BenJWagner/MIYbot/README.md

# MIYbot
MIYbot software and documentation
