BenJWagner/MIYbot/MIYBot Circuit Board BOM - Sheet1.pdf

Qty | Component | Approx Price | Price Each | Total | Souce 1 | Source 2 | Source 3 | Notes
1 | MIYBot Circuit Board | $50 for 10 | $5 | $5 | MIYElectronics.com (coming soon) | smart-prototyping.com | oshpark.com | My website will sell them or you can download the Gerber and drill files and submit them to be manufactured
1 | Pro Trinket 5V | $10 | $10 | $10 | https://www.adafruit.com | | | In bulk they are cheaper. Adafruit has lots of other cool stuff. Shop around!
1 | 24 pin 0.6" wide socket dual wipe | $0.30 | $0.30 | $0.30 | https://www.jameco.com | http://www.ebay.com/itm/A | | On ebay search for 24 pin .6 inch socket. Do not get machine pins
| | | | | let/ProductDisplay?langI | UGAT-TYCO-24-PIN-x-6-
| | | | | d=-1&storeId=10001&catalo | PC-IC-SOCKETS-20-pcs-
| | | | | gId=10001&productId=1 | m2803b7d543:g:o5UAAOS
| | | | | 12264 (https://www.jameco.com/webapp/wcs/stores/servlet/ProductDisplay?productId=112264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) | w3ydVqEBT (http://www.ebay.com/itm/AUGAT-TYCO-24-PIN-x-6-PC-IC-SOCKETS-20-pcs-/171861071171)
1 | 40 pin row of male headers - thes | 10 for $1 | $0.10 | $0.10 | http://www.jameco.com/ | http://www.ebay.com/itm/1 | | Buy in bulk on ebay. Gold ones are better. Need 1 row per board

/products/2000 (https://www.adafruit.com/products/2000)

/webapp/wcs/stores/serv

/171861071171?hash=ite

webapp/wcs/stores/servl
et/Product_10001_1000 | m3ab6c213d5:g:YZ4AAOS
1_2168211_-1 (http://www.jameco.com/webapp/wcs/stores/servlet/Product_10001_10001_2168211_-1) | wu4BVufST (http://www.ebay.com/itm/10pcs-lot-Connector-2-54mm-40-Pin-Male-Single-Row-Gold-Pin-Header-Strip-New-/252174275541)
1 | Common Cathode RGB LED 5m | 100 for $15 | $0.15 | $0.15 | http://www.jameco.com/ | http://www.ebay.com/itm/5 | Buy in bulk on ebay. Make sure you buy Common cathode.

0pcs-lot-Connector-2-
54mm-40-Pin-Male-Single-Row-Gold-Pin-Header-Strip-New-
/252174275541?hash=ite
webapp/wcs/stores/servl | /301716734051?hash=ite
et/Product_10001_1000 | m463fb80063:g:a7QAAOS
1_2125181_-1 (http://www.jameco.com/webapp/wcs/stores/servlet/Product_10001_10001_2125181_-1) | wDNdV007L (http://www.ebay.com/itm/5mm-Water-clear-RGB-Color-LED-Common-Cathode-Pack-of-10-E6-2-/301716734051)
2 | Pushbutton Switches Tactile 6mm | 100 for $5 | $0.05 | $0.10 | http://www.jameco.com/ | http://www.ebay.com/itm/1 | http://www.adafruit.co | Common part. Buy on ebay. Search for Tactile Push Button Switch Momentary 6x6x5mm 4 Pin DIP Through-Hole

mm-Water-clear-RGB-Color-LED-Common-Cathode-Pack-of-10-E6-2-

webapp/wcs/stores/servl
et/Product_10001_1000 | m5402564d41:g:B0UAAOx
1_119011_-1 (http://www.jameco.com/webapp/wcs/stores/servlet/Product_10001_10001_119011_-1) | yrrpThbAt (http://www.ebay.com/itm/100-Pcs-Tactile-Tact-Push-Button-Switch-Momentary-6x6x5mm-4-Pin-DIP-Through-Hole-/360816463169) | m/products/367 (http://www.adafruit.com/products/367)
2 | Slide Switches 0.1" pitch spdt 2 p | 100 for $5 | $0.05 | $0.10 | http://www.jameco.com/ | http://www.ebay.com/itm/1 | Common part. Buy on ebay. Search for SPDT 1P2T 2 Position 3 Pin PCB Panel Vertical Slide Switch

00-Pcs-Tactile-Tact-Push-Button-Switch-Momentary-6x6x5mm-4-Pin-DIP-Through-Hole-
/360816463169?hash=ite

webapp/wcs/stores/servl
et/Product_10001_1000 | m2ca1c20600:g:2CsAAOS
1_2258831_-1 (http://www.jameco.com/webapp/wcs/stores/servlet/Product_10001_10001_2258831_-1) | w37tV-TAt (http://www.ebay.com/itm/100pcs-NEW-SS12D00G4-SPDT-1P2T-2-Position-3-Pin-PCB-Panel-Vertical-Slide-Switch-/191692408320)
3 | 220 ohm 1/4 w resistors | $0.01 | $0.01 | $0.03 | http://www.jameco.com/ | Buy in bulk. You can buy these from ebay too, but they are very cheap from Jameco

00pcs-NEW-SS12D00G4-
SPDT-1P2T-2-Position-3-
Pin-PCB-Panel-Vertical-Slide-Switch-
/191692408320?hash=ite

webapp/wcs/stores/servl
et/Product_10001_1000
1_690700_-1 (http://www.jameco.com/webapp/wcs/stores/servlet/Product_10001_10001_690700_-1)
2 | 10K ohm 1/4w resistors | $0.01 | $0.01 | $0.02

http://www.jameco.com/
webapp/wcs/stores/servl
et/Product_10001_1000
1_691104_-1 (http://www.jameco.com/webapp/wcs/stores/servlet/Product_10001_10001_691104_-1)

Buy in bulk. You can buy these from ebay too, but they are very cheap from Jameco

1 | 12mm piezo Buzzer Transducer 8 | $1 from Jameco, | $1 | $1

https://www.jameco.com
/webapp/wcs/stores/serv
let/ProductDisplay?langI | Beep-Tone-Alarm-Ringer-
d=-1&storeId=10001&catalo | 12mm-/321600017267?hash=ite
gId=10001&productId=2 | m4ae0dad373:g:iFIAAOSw
210968 (https://www.jameco.com/webapp/wcs/stores/servlet/ProductDisplay?productId=2210968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) | ofxUduG1 (http://www.ebay.com/itm/10Pcs-5v-Active-Buzzer-Magnetic-Long-Continous-Beep-Tone-Alarm-Ringer-12mm-/321600017267)
1 | Screw Terminal 2 pos 3.81 mm pit | 100 for $18 | 0.18 | 0.18 | https://www.jameco.com/webapp/wcs/stores/serv | http://www.ebay.com/itm/1 | Search for screw terminal 3.81 2 pos. Do not buy 5mm!

http://www.ebay.com/itm/1
0Pcs-5v-Active-Buzzer-Magnetic-Long-Continous-

Cheaper on ebay. Search for 12mm buzzer piezo 5v arduino

let/Product_10001_1000 | m51dbee1a69:g:0ogAAOx
1_2094506_-1 (https://www.jameco.com/webapp/wcs/stores/servlet/Product_10001_10001_2094506_-1) | yOnRR7jS2 (http://www.ebay.com/itm/100-pcs-3-81mm-Pitch-150V-9A-2P-Poles-PCB-Screw-Terminal-Block-Connector-Green-/351582165609)
1 | 4 AA battery holder | $1.20 | $1.20 | $1.20 | https://www.jameco.com/webapp/wcs/stores/serv | http://www.ebay.com/itm/L | Very common part. Buy on ebay or Jameco. Swich on holder is not needed.

00-pcs-3-81mm-Pitch-150V-9A-2P-Poles-PCB-Screw-Terminal-Block-Connector-Green-
/351582165609?hash=ite
let/Product_10001_1000 | m2a1ee77112:g:frcAAOSw
1_216152_-1 (https://www.jameco.com/webapp/wcs/stores/servlet/Product_10001_10001_216152_-1) | q7JUGVXK (http://www.ebay.com/itm/Lot-10-Pcs-New-4AA-2A-Battery-6V-Clip-Holder-Box-Case-with-6-Leads-Black-/180907110674)
1 | HC-SR04 Ultrasonic Sensor | $1.25 | $1.25 | $1.25 | http://www.amazon.com/ | http://www.ebay.com/itm/5 | Buy on ebay. Search for HC-SR04 ultrasonic sensor
| | | | | Ultrasonic-Distance-Measuring-Transducer- | pcs-Ultrasonic-Module-HC-
| | | | | Arduino/dp/B0181ZBL9Y /ref=sr_1_8?s=wireless& ie=UTF8&qid=14481321 | Transducer-Sensor-for-Arduino-/381374789471?hash=ite
| | | | | 94&sr=1-8&keywords=hc-sr04 (http://www.amazon.com/Ultrasonic-Distance-Measuring-Transducer-Arduino/dp/B0181ZBL9Y?s=wireless) | m58cbb5775f:g:Rd0AAOxy
1 | QTR-1RC Reflectance Sensor (2-Pac | $4.25 | $4.25 | $4.25 | https://www.pololu.com/ | http://www.robotshop.com/ | Needed if you want to be able to sense black and white lines

ot-10-Pcs-New-4AA-2A-Battery-6V-Clip-Holder-Box-Case-with-6-Leads-Black-
/180907110674?hash=ite

SR04-Distance-Measuring-

SoJTWL-h (http://www.ebay.com/itm/5pcs-Ultrasonic-Module-HC-SR04-Distance-Measuring-Transducer-Sensor-for-Arduino-/381374789471)

product/2459 (https://www.pololu.com/product/2459) | ZoskCFYRCaQodSk4Kgw (http://www.robotshop.com/en/pololu-qtr-1rc-reflectance-sensor-2pk.html)
2 | FEETECH FS90R Micro Continuo | $5 | $5 | $10 | https://www.pololu.com/ | http://www.robotshop.com/ | Might be possible to buy directly from Feetech in China. Make sure they are continuous rotation!

en/pololu-qtr-1rcreflectance-sensor-2pk.html?gclid=CM2e0OK

product/2820 (https://www.pololu.com/product/2820) | OaoskCFQ-oaQoddckBWg (http://www.robotshop.com/en/9g-continuous-rotation-micro-servo.html?gclid=CJG25bOaoskCFQ-oaQoddckBWg)
1 | Dupont wire 20cm 40 pieces Fem | $3 | $3 | $3 | http://www.ebay.com/itm | http://www.amazon.com/40 | These ribbon cables can be pulled apart and used for multiple robots. The wires are useful for connecting the board to the sensors.

en/9g-continuous-rotationmicroservo.html?gclid=CJG25b

/40pcs-20cm-2-54mm-Male-to-Female-Dupont-
Wire-Jumper-Cable-for- | PCS-Dupont-cable-color-
Arduino-Breadboard-/321756141990?hash=it | connector/dp/B007XPSVM
em4aea2919a6:g:l80AA OSwBvNTm8tA (http://www.ebay.com/itm/40pcs-20cm-2-54mm-Male-to-Female-Dupont-Wire-Jumper-Cable-for-Arduino-Breadboard-/321756141990) | d=1448140864&sr=8-2&keywords=dupont+wire (http://www.amazon.com/40PCS-Dupont-cable-color-connector/dp/B007XPSVMY)

Y/ref=sr_1_2?ie=UTF8&qi

Total | $37

gp/product/B00OC6WR2
2?psc=1&redirect=true&
ref_=oh_aui_detailpage_
o01_s00 (http://www.amazon.com/gp/product/B00OC6WR22?psc=1&redirect=true&ref_=oh_aui_detailpage_o01_s00)
Soldering Iron | $20 - $80

http://www.amazon.com/
Stahl-Tools-SSVT-Temperature-Soldering/dp/B0029N70
WM/ref=sr_1_17?ie=UT
F8&qid=1448133436&sr | YO/ref=sr_1_3?ie=UTF8&
=8-17&keywords=soldering | qid=1448133471&sr=8-3&keywords=soldering+iro
+iron (http://www.amazon.com/Stahl-Tools-SSVT-Temperature-Soldering/dp/B0029N70WM) | n+xtronic (http://www.amazon.com/X-TRONIC-MODEL-4010-XTS-Centigrade-ANTI-MAGNETIC/dp/B0053491YO)
| 60/40 Tin/Lead Solder | $30 / lb | http://www.amazon.com/ | Tin/Lead is the easiest to work with for new solderers. Wash hands after handling.

http://www.amazon.com/X-TRONIC-MODEL-4010-
XTS-Centigrade-ANTI-MAGNETIC/dp/B0053491

My class uses the Stahl tools one. I use the Xtronic one at home.

Kester-24-6040-0061-
Rosin-Solder-Diameter/dp/B00FGHT1
2A/ref=sr_1_1?ie=UTF8
&qid=1448133678&sr=8
1&keywords=60+40+tin+
lead+solder+kester (http://www.amazon.com/Kester-24-6040-0061-Rosin-Solder-Diameter/dp/B00FGHT12A)
Metal Solder Sponge | $8

http://www.amazon.com/
Aoyue-Soldering-Cleaner-spongeneeded/dp/B005C789E
U/ref=sr_1_5?ie=UTF8&
qid=1448133763&sr=8-
5&keywords=solder+spo
nge (http://www.amazon.com/Aoyue-Soldering-Cleaner-sponge-needed/dp/B005C789EU)
Wire Snips | $5

http://www.amazon.com/
Hakko-CHP-170-Standoff-Construction-21-
Degree/dp/B017ODDPN
O/ref=sr_1_1?s=powerhandtools&ie=UTF8&qid=144
8133789&sr=1-
1&keywords=wire+cutter
s (http://www.amazon.com/Hakko-CHP-170-Stand-off-Construction-21-Degree/dp/B017ODDPNO?s=power-hand-tools)
Safety Glasses | $5

No recommendation other than to have them!

| Other supplies needed - these are some of the supplies I use. Your mileage might vary.
1 | micro USB cable for programming | 10 for $15 | $1.50 | http://www.amazon.com/ | Any micro usb data/power cable will work and can be reused.

Solder Sucker | $20

http://www.amazon.com/
Edsyn-Deluxe-Soldapullt-Heavy-Vacuum/dp/B006GOKV
KI/ref=sr_1_8?s=powerhandtools&ie=UTF8&qid=144
8133896&sr=1-
8&keywords=solder+suc
ker (http://www.amazon.com/Edsyn-Deluxe-Soldapullt-Heavy-Vacuum/dp/B006GOKVKI?s=power-hand-tools)
Hot Glue Gun / Hot Glue Sticks | $10 | I buy these at Walmart or Michaels
