BenJWagner/MIYbot/MIYBot Circuit Board BOM.xlsx

Qty | Component | Approx Price | Price Each | Total | Souce 1 | Source 2 | Source 3 | Notes
1 | MIYBot Circuit Board | $50 for 10 | $5 | $5 | MIYElectronics.com (coming soon) | smart-prototyping.com | oshpark.com | My website will sell them or you can download the Gerber and drill files and submit them to be manufactured
1 | Pro Trinket 5V | $10 | $10 | $10 | https://www.adafruit.com/products/2000 |  |  | In bulk they are cheaper. Adafruit has lots of other cool stuff. Shop around!
1 | 24 pin 0.6" wide socket dual wipe (NOT MACHINE PINS) | $0.30 | $0.30 | $0.30 | https://www.jameco.com/webapp/wcs/stores/servlet/ProductDisplay?productId=112264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 | http://www.ebay.com/itm/AUGAT-TYCO-24-PIN-x-6-PC-IC-SOCKETS-20-pcs-/171861071171 |  | On ebay search for 24 pin .6 inch socket. Do not get machine pins
1 | 40 pin row of male headers - these can be clipped apart and separated. 0.1 inch pich single row | 10 for $1 | $0.10 | $0.10 | http://www.jameco.com/webapp/wcs/stores/servlet/Product_10001_10001_2168211_-1 | http://www.ebay.com/itm/10pcs-lot-Connector-2-54mm-40-Pin-Male-Single-Row-Gold-Pin-Header-Strip-New-/252174275541 |  | Buy in bulk on ebay. Gold ones are better. Need 1 row per board
1 | Common Cathode RGB LED 5mm | 100 for $15 | $0.15 | $0.15 | http://www.jameco.com/webapp/wcs/stores/servlet/Product_10001_10001_2125181_-1 | http://www.ebay.com/itm/5mm-Water-clear-RGB-Color-LED-Common-Cathode-Pack-of-10-E6-2-/301716734051 |  | Buy in bulk on ebay. Make sure you buy Common cathode.
2 | Pushbutton Switches Tactile 6mm | 100 for $5 | $0.05 | $0.10 | http://www.jameco.com/webapp/wcs/stores/servlet/Product_10001_10001_119011_-1 | http://www.ebay.com/itm/100-Pcs-Tactile-Tact-Push-Button-Switch-Momentary-6x6x5mm-4-Pin-DIP-Through-Hole-/360816463169 | http://www.adafruit.com/products/367 | Common part. Buy on ebay. Search for Tactile Push Button Switch Momentary 6x6x5mm 4 Pin DIP Through-Hole
2 | Slide Switches 0.1" pitch spdt 2 pos 3 pin | 100 for $5 | $0.05 | $0.10 | http://www.jameco.com/webapp/wcs/stores/servlet/Product_10001_10001_2258831_-1 | http://www.ebay.com/itm/100pcs-NEW-SS12D00G4-SPDT-1P2T-2-Position-3-Pin-PCB-Panel-Vertical-Slide-Switch-/191692408320 |  | Common part. Buy on ebay. Search for SPDT 1P2T 2 Position 3 Pin PCB Panel Vertical Slide Switch
3 | 220 ohm 1/4 w resistors | $0.01 | $0.01 | $0.03 | http://www.jameco.com/webapp/wcs/stores/servlet/Product_10001_10001_690700_-1 |  |  | Buy in bulk. You can buy these from ebay too, but they are very cheap from Jameco
2 | 10K ohm 1/4w resistors | $0.01 | $0.01 | $0.02 | http://www.jameco.com/webapp/wcs/stores/servlet/Product_10001_10001_691104_-1 |  |  | Buy in bulk. You can buy these from ebay too, but they are very cheap from Jameco
1 | 12mm piezo Buzzer Transducer 85dB 5Vp-p | $1 from Jameco, $0.2 from ebay | $1 | $1 | https://www.jameco.com/webapp/wcs/stores/servlet/ProductDisplay?productId=2210968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 | http://www.ebay.com/itm/10Pcs-5v-Active-Buzzer-Magnetic-Long-Continous-Beep-Tone-Alarm-Ringer-12mm-/321600017267 |  | Cheaper on ebay. Search for 12mm buzzer piezo 5v arduino
1 | Screw Terminal 2 pos 3.81 mm pitch. Do not buy 5mm pitch | 100 for $18 | 0.18 | 0.18 | https://www.jameco.com/webapp/wcs/stores/servlet/Product_10001_10001_2094506_-1 | http://www.ebay.com/itm/100-pcs-3-81mm-Pitch-150V-9A-2P-Poles-PCB-Screw-Terminal-Block-Connector-Green-/351582165609 |  | Search for screw terminal 3.81 2 pos. Do not buy 5mm!
1 | 4 AA battery holder | $1.20 | $1.20 | $1.20 | https://www.jameco.com/webapp/wcs/stores/servlet/Product_10001_10001_216152_-1 | http://www.ebay.com/itm/Lot-10-Pcs-New-4AA-2A-Battery-6V-Clip-Holder-Box-Case-with-6-Leads-Black-/180907110674 |  | Very common part. Buy on ebay or Jameco. Swich on holder is not needed.
1 | HC-SR04 Ultrasonic Sensor | $1.25 | $1.25 | $1.25 | http://www.amazon.com/Ultrasonic-Distance-Measuring-Transducer-Arduino/dp/B0181ZBL9Y?s=wireless | http://www.ebay.com/itm/5pcs-Ultrasonic-Module-HC-SR04-Distance-Measuring-Transducer-Sensor-for-Arduino-/381374789471 |  | Buy on ebay. Search for HC-SR04 ultrasonic sensor
1 | QTR-1RC Reflectance Sensor (2-Pack) | $4.25 | $4.25 | $4.25 | https://www.pololu.com/product/2459 | http://www.robotshop.com/en/pololu-qtr-1rc-reflectance-sensor-2pk.html |  | Needed if you want to be able to sense black and white lines
2 | FEETECH FS90R Micro Continuous Rotation Servo | $5 | $5 | $10 | https://www.pololu.com/product/2820 | http://www.robotshop.com/en/9g-continuous-rotation-micro-servo.html?gclid=CJG25bOaoskCFQ-oaQoddckBWg |  | Might be possible to buy directly from Feetech in China. Make sure they are continuous rotation!
1 | Dupont wire 20cm 40 pieces Female connectors both ends | $3 | $3 | $3 | http://www.ebay.com/itm/40pcs-20cm-2-54mm-Male-to-Female-Dupont-Wire-Jumper-Cable-for-Arduino-Breadboard-/321756141990 | http://www.amazon.com/40PCS-Dupont-cable-color-connector/dp/B007XPSVMY |  | These ribbon cables can be pulled apart and used for multiple robots. The wires are useful for connecting the board to the sensors.
 |  |  | Total | $37
 | Other supplies needed - these are some of the supplies I use. Your mileage might vary.
1 | micro USB cable for programming | 10 for $15 | $1.50 |  | http://www.amazon.com/gp/product/B00OC6WR22?psc=1&redirect=true&ref_=oh_aui_detailpage_o01_s00 |  |  | Any micro usb data/power cable will work and can be reused.
 | Soldering Iron | $20 - $80 |  |  | http://www.amazon.com/Stahl-Tools-SSVT-Temperature-Soldering/dp/B0029N70WM | http://www.amazon.com/X-TRONIC-MODEL-4010-XTS-Centigrade-ANTI-MAGNETIC/dp/B0053491YO |  | My class uses the Stahl tools one. I use the Xtronic one at home.
 | 60/40 Tin/Lead Solder | $30 / lb |  |  | http://www.amazon.com/Kester-24-6040-0061-Rosin-Solder-Diameter/dp/B00FGHT12A |  |  | Tin/Lead is the easiest to work with for new solderers. Wash hands after handling.
 | Metal Solder Sponge | $8 |  |  | http://www.amazon.com/Aoyue-Soldering-Cleaner-sponge-needed/dp/B005C789EU
 | Wire Snips | $5 |  |  | http://www.amazon.com/Hakko-CHP-170-Stand-off-Construction-21-Degree/dp/B017ODDPNO?s=power-hand-tools
 | Safety Glasses | $5 |  |  |  |  |  | No recommendation other than to have them!
 | Solder Sucker | $20 |  |  | http://www.amazon.com/Edsyn-Deluxe-Soldapullt-Heavy-Vacuum/dp/B006GOKVKI?s=power-hand-tools
 | Hot Glue Gun / Hot Glue Sticks | $10 |  |  |  |  |  | I buy these at Walmart or Michaels
