BenJWagner/MIYbot/MiscDesign/castor23.8.stl

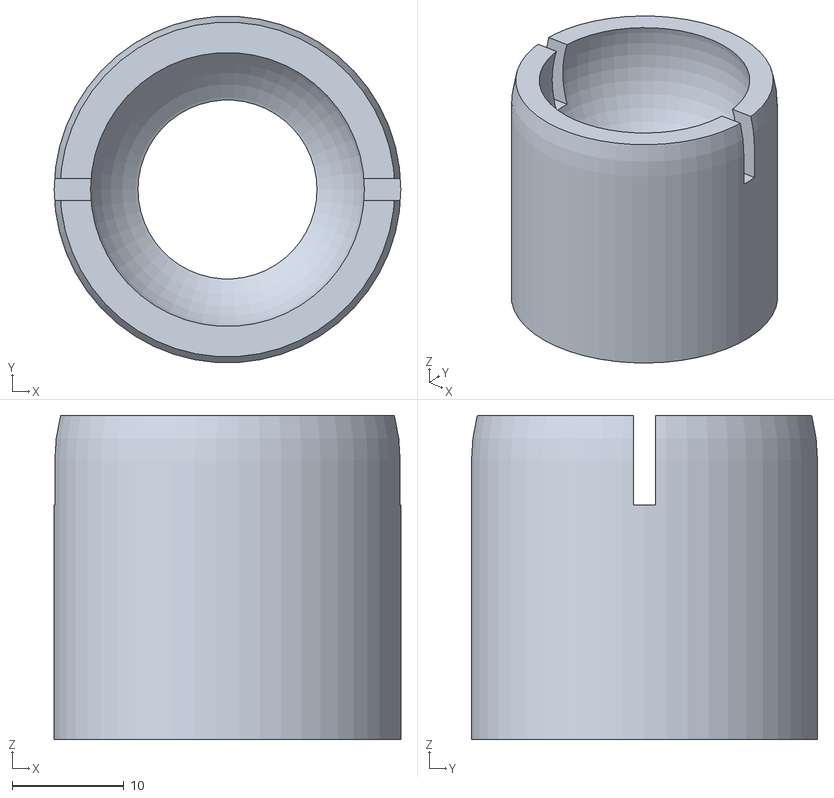
[picture p25: CAD file, 2015-11-29]
MiscDesign/castor23.8.stl
31.0 x 30.9 x 29.0
