BenJWagner/MIYbot/MiscDesign/castor24.75.stl

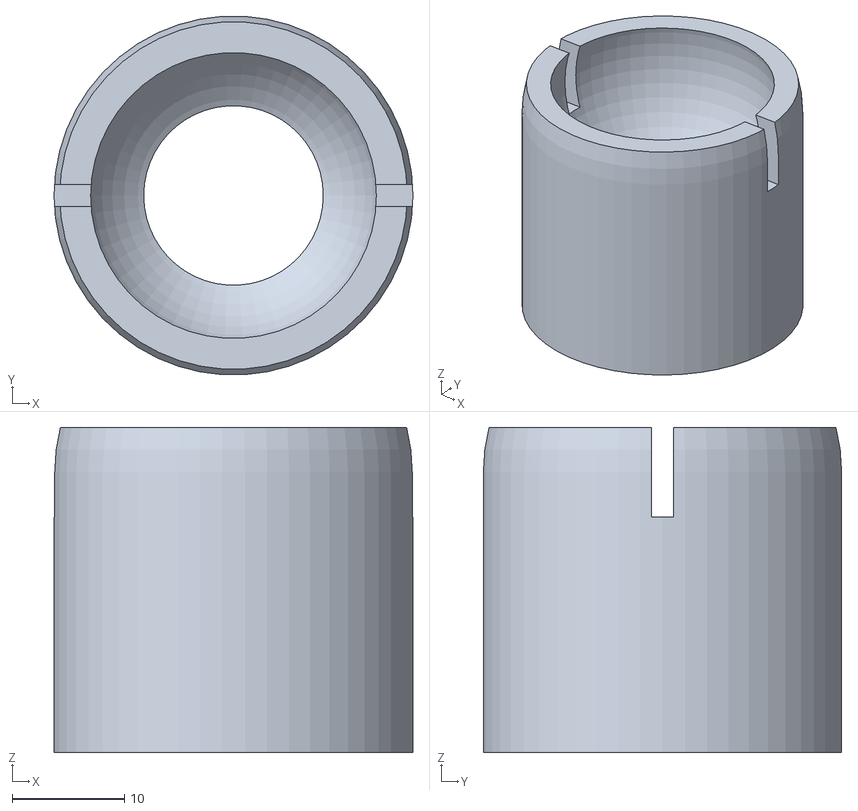
[picture p26: CAD file, 2015-11-29]
MiscDesign/castor24.75.stl
32.0 x 31.9 x 29.0
