BenJWagner/MIYbot/MiscDesign/castor24.25.stl

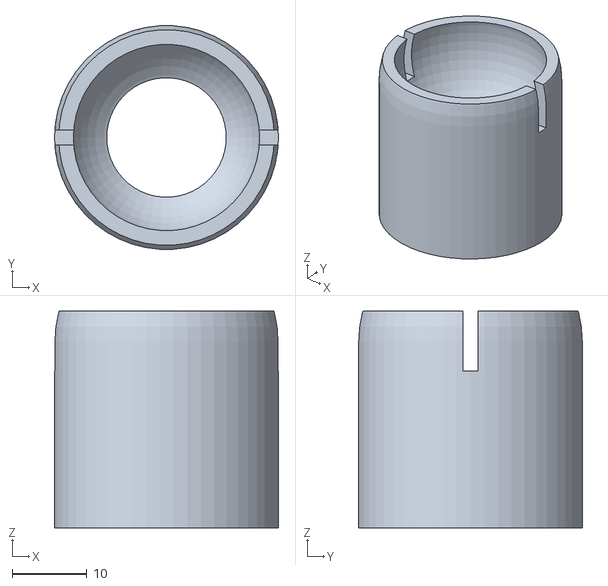
[picture p27: CAD file, 2015-11-29]
MiscDesign/castor24.25.stl
30.0 x 29.9 x 29.0
