BenJWagner/MIYbot/(list of files, cad)

Other CAD files:
MiscDesign/castor24.stl
MiscDesign/castor24.5.stl
