BenJWagner/MIYbot/(list of files, drawings)

Other design files:
CircuitBoard/MIYbot2.dch
CircuitBoard/MIYbot2.dip
CircuitBoard/MIYbot3.dip
