BenJWagner/MIYbot/(commit log)

2015-11-29 More documents
    [MIYbot2.dch, MIYbot2.dip, castor.scad, castor23.8.stl, castor24.25.stl, castor24.5.stl, castor24.75.stl, castor24.stl]
2015-12-03 Polished the files. Moved stuff to folders
    [MIYBot Circuit Board BOM.xlsx, MIYbot2.dch, MIYbot2.dip, castor.scad, castor23.8.stl, castor24.25.stl, castor24.5.stl, castor24.75.stl]
2017-06-14 Added latest miybot circuit board changes. Also added MIYBOTSumo.ino
    [MIYbot3.dip]
